RobertRol/IntercomLightSensor/README.md

## Objectives

Short story:

1. Detection of a flashing light signal from an intercom button (without opening and/or changing the wiring of the intercom)
2. Wireless transmission of the signal to another portable device (receiver)
3. Low power consumption: both sensor-transmitter (implemented in one device) and receiver should run for several months on batteries
4. Receive the signal anywhere in the apartment

... basically, it's something like a portable "repeater" for light signals.

Click [here for the long story](#long-story).

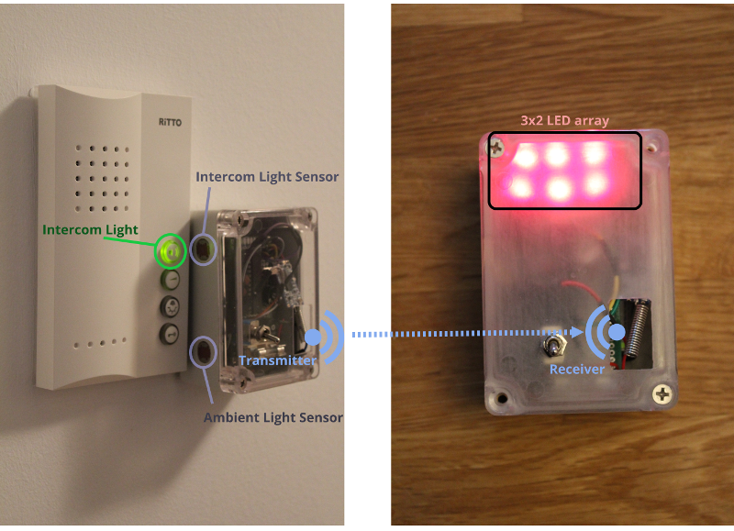
[picture p1: pics/DesignSmall.png]
Solution


## Overview
1. [Links](#links)
2. [Sensor](#sensor)
3. [Transmitter](#transmitter)
4. [Receiver](#receiver)
5. [Power Source and Consumption](#power-source-and-consumption)
5. [Photos](#photos)
5. [Long Story](#long-story)

Sections [Sensor](#sensor), [Transmitter](#transmitter) and [Receiver](#receiver) include rudimentary parts lists.
Sections [Transmitter](#transmitter) and [Receiver](#receiver) also include links to respective sketchbook code.

## Links
The low power objective turned out to be really tricky but the website https://www.gammon.com.au/power was incredibly helpful -- especially the post about the low-power temperature monitor.
My main take-aways from the website:
1. Go for a bare ATmega328P-PU board implementation (rather than using an Arduino Nano or similar)
2. Use a watchdog timer to periodically wake up the processor from sleep mode
3. Reduce processor frequency and voltage

Descriptions on how to set up a bare microprocessor board can be found on https://www.gammon.com.au/power and https://www.arduino.cc/en/Main/Standalone.

I also ran into some dead ends with the wireless data transmission. In the end, I got it working with the HC-12 wireless module. Its documentation can be found here: https://statics3.seeedstudio.com/assets/file/bazaar/product/HC-12_english_datasheets.pdf.

The ATmega328P-PU microprocessors I bought did not have a bootloader installed. I used my Elegoo Uno R3 development board to burn the bootloader onto the ATmegas. A description of the procedure and a simple bread board layout can be found here: https://www.arduino.cc/en/Tutorial/ArduinoToBreadboard

I also used using my Elegoo Uno R3 development board to upload the sketches to the microprocessors. Remember to set the right processor type in your Arduino IDE (in my case Tools -> Board -> Arduino Duemilanove w/ Atmega 328)

The ATmega328P-PU pin layout is given here: https://www.arduino.cc/en/Hacking/PinMapping168

## Sensor
The main part of the sensor is a voltage divider composed of two light-dependent resistors (LDRs). One of the LDRs is placed right in front of the intercom light ("intercom LDR"), the other one a bit away from it ("ambient LDR"). The voltage drop across the ambient LDR is then used as an input to `analogRead` in the [sensor-transmitter code](https://github.com/RobertRol/IntercomLightSensor/blob/master/SensorTransmitter.ino).
The reason for using two LDRs is that the sensor reading should not depend on the ambient light level, i.e., the sensor needs to work during the day and at night. By using a voltage divider with a second (ambient) LDR, the sensor only measures the difference between intercom light and ambient light level.

Since the sensor is always "on" in my design, it was important to use LDRs with a high resistance in order to minimize power drain. I used two 12mm GL12537 LDRs, which have about 40kOhm/4kOhm in dark/bright state, respectively. Additionally, I have added another 0-10kOhm potentiometer to adjust for any differences in resistance between the two LDRs.

Sensor schematic

Parts list:
* R1, R2 https://www.alibaba.com/product-detail/GL12537-1-CdS-Photoresistor-GM12537-1_1894530106.html
* R3 standard 10kOhm variable resistor (actually, it turned out that the two LDR resistances are very similar so that adding the variable resistor is not necessary)
* C1 standard 0.1µF ceramic capacitor for noise reduction

## Transmitter
[Link](https://github.com/RobertRol/IntercomLightSensor/blob/master/SensorTransmitter.ino) to code.

Wireless transmission of the light-triggered signal is performed via an HC-12 transceiver module. While its transmission range turned out to be much better than the ones of cheaper Arduino RF modules, it's still not good enough to receive the signal everywhere in my apartment. However, after cutting holes into the lids right in front of the transceiver antennas (see photos in section [Objectives](#objectives)), I get a pretty good coverage throughout my apartment.

Important note about digital pins 0 and 1 of the ATmega328P-PU and the SoftwareSerial library: It seems as if you cannot use them as RX/TX pins when setting up a `SoftwareSerial` object, see http://forum.arduino.cc/index.php?topic=412164.0. At least I did not manage to get the RF communication working when using pins 0 and 1.

Another important note: If the `AREF` pin is connected to an external voltage source, the source code must include the line
```C
analogReference(EXTERNAL);
```
Otherwise, the microcontroller might get damaged!

In a nutshell, the sensor-transmitter code performs the following steps:

1. Every 256ms, the ATmega328P-PU microcontroller is woken up from state `SLEEP_MODE_PWR_DOWN` via a watchdog timer.
2. The microcontroller takes 5 subsequent analog readings of the voltage drop across the ambient LDR. The readings are filtered using an [exponentially-weighted moving average](https://en.wikipedia.org/wiki/Moving_average#Exponential_moving_average) in order to reduce noise and to allow for the internal `analogRead` circuitry to adjust to the sensor impedance.
3. The filtered value is then compared to the corresponding value from the previous sleep-wake cycle. If there is a "significant" change, the HC-12 module is woken up from sleep mode and a signal is sent to the receiver (repeated 2 times with a delay of 2000ms). Otherwise, the HC-12 stays in sleep mode. The HC-12 module is set back to sleep mode (22µA idle current), after the signal was transmitted.

The trasmission electronics is depicted on the left-hand-side part of the schematic given below; the sensor is given on the right-hand-side.
Pins A4 and A5 can be used to send optional debugging messages via the I2C bus.

Sensor-Transmitter schematic

Parts list:
* R1, R2, R3, C1 ... see parts list of [Sensor](#sensor) section above
* R4 ... 10kOhm pull-up resistor
* C2, C3 ... 22pF ceramic capacitors for crystal oscillator
* C4, C5 ... 0.1µF ceramic capacitor for noise reduction
* 8MHz crystal oscillator
* HC-12 RF tranceiver module https://statics3.seeedstudio.com/assets/file/bazaar/product/HC-12_english_datasheets.pdf

## Receiver
[Link](https://github.com/RobertRol/IntercomLightSensor/blob/master/Receiver.ino) to code.

The receiver module uses another HC-12 module to detect the signals from the sensor-transmitter.

1. In order to save energy, the microprocessor of the receiver is put into `SLEEP_MODE_PWR_DOWN`. The HC-12 module is also put into power saving mode `AT+FU2`, where it draws about 80-90µA (not to be confused with sleep mode).
2. I have noticed that upon incoming RF signals, the HC-12 module changes the voltage on its TXD pin. This voltage change can be used to wake up the ATmega microprocessor via an hardware interrupt (see the connection of the TXD pin to pin `D3` of the ATmega below). Information on how to use interrupts can be found [here]( https://www.arduino.cc/reference/en/language/functions/external-interrupts/attachinterrupt/).
3. After the ATmega microprocessor is woken up, it flashes a small 3x2 LED array for a few times.
4. Finally, the ATmega328P-PU is put back into mode `SLEEP_MODE_PWR_DOWN`.

Pins A4 and A5 can be used to send optional debugging messages via the I2C bus.

Receiver schematic

Parts list:
* basically the same as in section [Transmitter](#transmitter), but with the reset pull-up resistor now denoted by R7
* R1-R6, 220 Ohm resistors for the LEDs
* L1-L6, red LEDs

## Power Source and Consumption
### Receiver
I use 3 serially-connected high-capacity AA rechargeable batteries as power source for both the sensor-transmitter and the receiver. This gives a voltage of approx. `3 x 1.2V = 3.6V` and a capacity of `3 x 2400mAh = 7200mAh`. With the receiver drawing roughly 90-200µA in idle mode, a 3xAA battery pack has more than enough energy to run the device for months.

### Sensor-Transmitter
The power consumption of the sensor-transmitter can be calculated. The microcontroller is woken up from state `SLEEP_MODE_PWR_DOWN` every 256ms. According to https://www.gammon.com.au/power, the ATmega328P-PU draws approximately 0.36mA in `SLEEP_MODE_PWR_DOWN`. The HC-12 module needs another 22µA in sleep mode.
The sensor takes 5 `analogRead` measurements of the voltage drop across the ambient LDR, where each reading takes about 100µs (see [link](https://www.arduino.cc/reference/en/language/functions/analog-io/analogread/)). I have added another 1ms delay between the readings via `delay(1)`. The total time of the reading is roughly 5.5ms (let's make it 6ms). While taking the measurements, the bare ATmega328P-PU board needs about 15mA and the HC-12 module draws 80-90µA.

The average current drain is therefore
```math
1/256ms *[(256ms-6ms)*(0.38mA+0.022mA) + 6ms*(15mA+0.09mA)] ~ 0.75mA
```
With a capacity of 7200mAh this gives an approximate run time of 400 days for a 3xAA battery pack.
This calculation does not take into account the energy needed to send RF signals. However, it does not happen very often that someone uses the intercom and the energy consumption for transmitting RF signals can therefore be neglected in our calculation. The same holds for the flashing LEDs of the receiver module.

## Photos
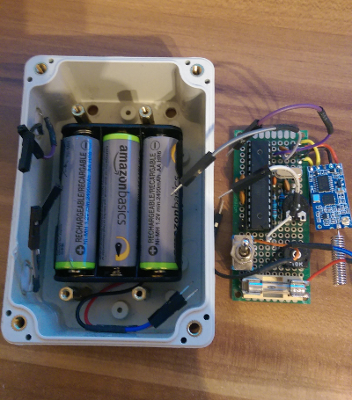
[picture p2: pics/sensorTransmitter400px.png]
SensorTransmitter open
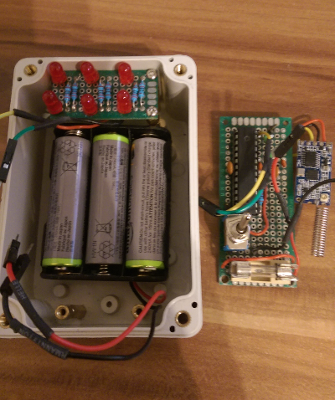
[picture p3: pics/receiver400px.png]
Receiver open
|  |  |
|:--:| :--:|
| *Sensor-Transmitter (open)* | *Receiver (open)* |

## Long story
Working at home comes with several advantages. One of them is that I am usually around when I am expecting a package from a parcel service. The problem is that I like to listen to music while coding and that I cannot hear the doorbell/intercom when my orders arrive. Here in Germany, the parcel services sometimes drop off the package for pick-up at the local post office in case you are not opening the door. However, it takes me about 15mins to get to the next post office. Not to mention the long waiting lines there...
So I decided to design a small device that detects when someone is using the intercom and that triggers a visual signal that I can see while I am sitting in front of my computer.
The easiest solution would have been to open my intercom device, find the wires that go to the buzzer and to use them as an interrupt. But I am renting my place and --cautious as I am-- potentially damaging the intercom was too risky for me. ;) Apart from the acoustic signal from the buzzer, my intercom also flashes a light when someone rings. So, I decided to detect this light signal and to transmit it _wirelessly_ to a small receiver that is just underneath my computer monitors.
