RobertRol/IntercomLightSensor/pics/receiverFlashing400px.png

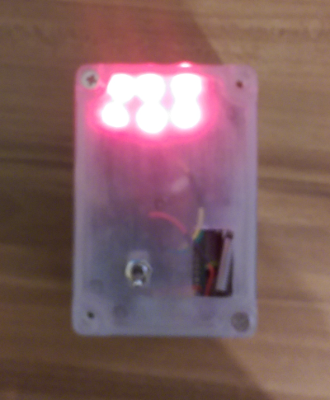
pics/receiverFlashing400px.png
