RobertRol/IntercomLightSensor/pics/sensorTransmitterSide400px.png

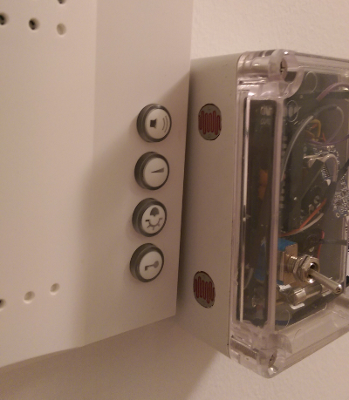
pics/sensorTransmitterSide400px.png
