RobertRol/IntercomLightSensor/(commit log)

2018-03-11 added sensor schematic
2018-03-11 new attempt for sensor schematic
2018-03-26 added LEDs
2018-03-26 changed voltage
